averyanalex/nto-aerospace-2023/hardware/source/CameraHolder.png

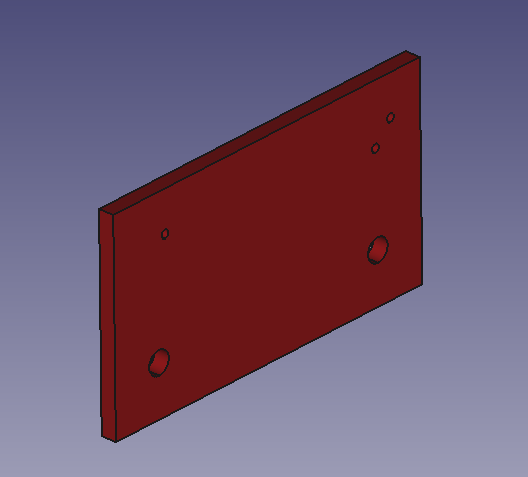
hardware/source/CameraHolder.png
