averyanalex/nto-aerospace-2023/hardware/source/Claw.png

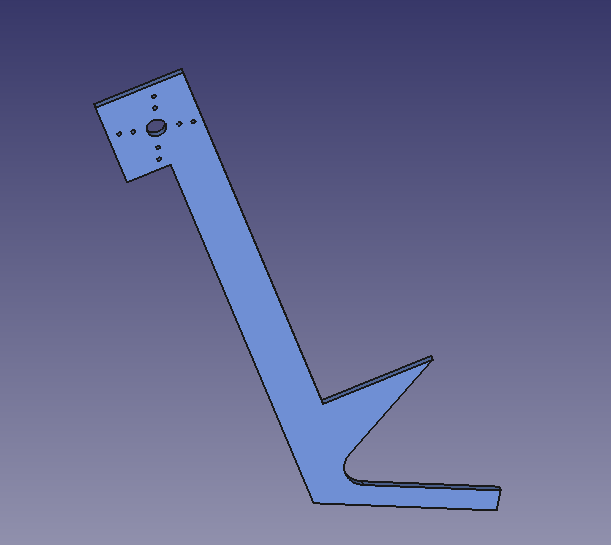
hardware/source/Claw.png
