averyanalex/nto-aerospace-2023/hardware/source/ClawDELETE.png

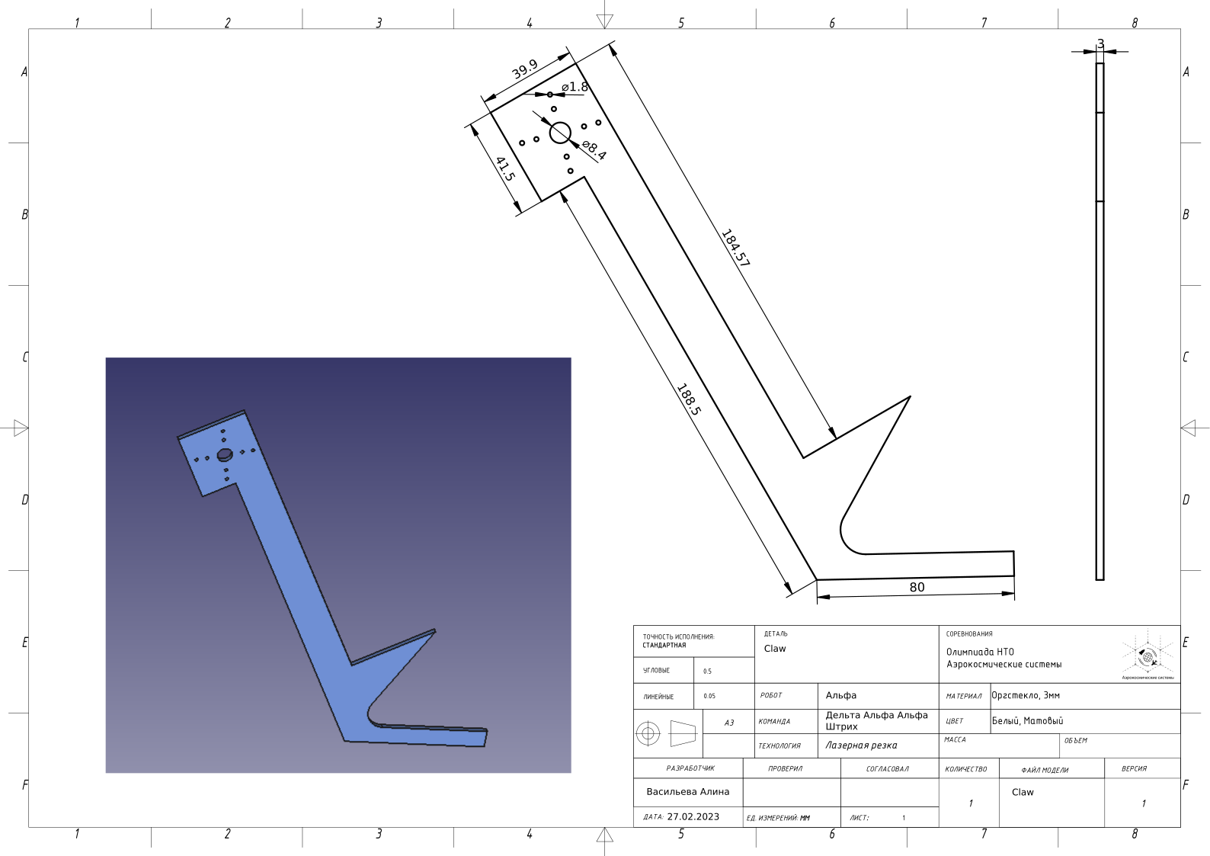
hardware/source/ClawDELETE.png
