averyanalex/nto-aerospace-2023/hardware/source/ServoHolder.png

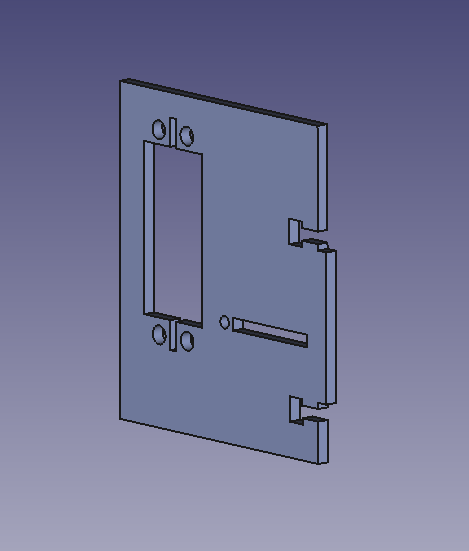
hardware/source/ServoHolder.png
