averyanalex/nto-aerospace-2023/hardware/source/ServoHolderRetainer.png

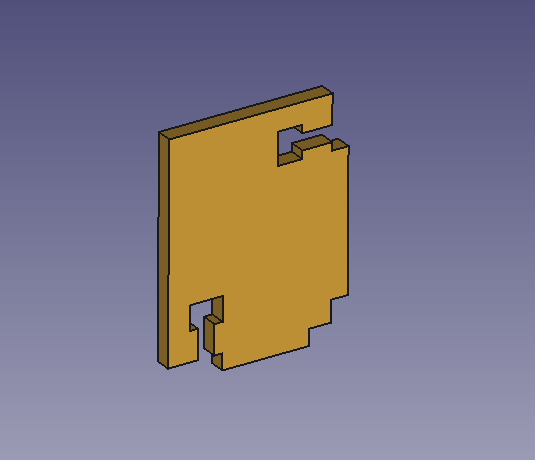
hardware/source/ServoHolderRetainer.png
