averyanalex/nto-aerospace-2023/hardware/source/TopPanel.png

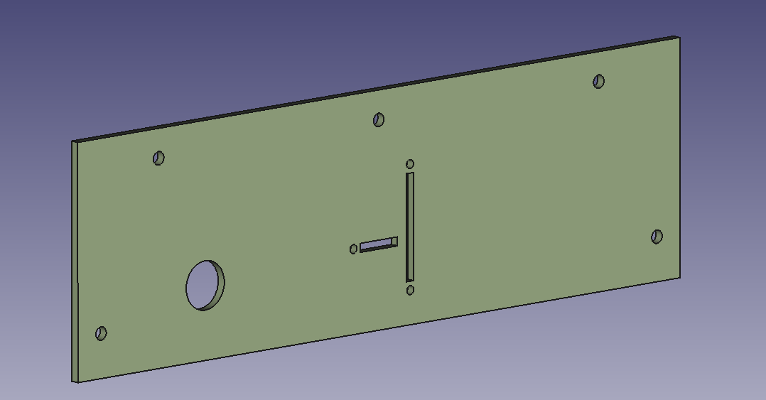
hardware/source/TopPanel.png
