averyanalex/nto-aerospace-2023/hardware/models/partslist.pdf

Команда "Дельта Альфа Альфа Штрих"
Список деталей для изготовления, Заказ №1
ПП | Модель | 3D | Название | Количество

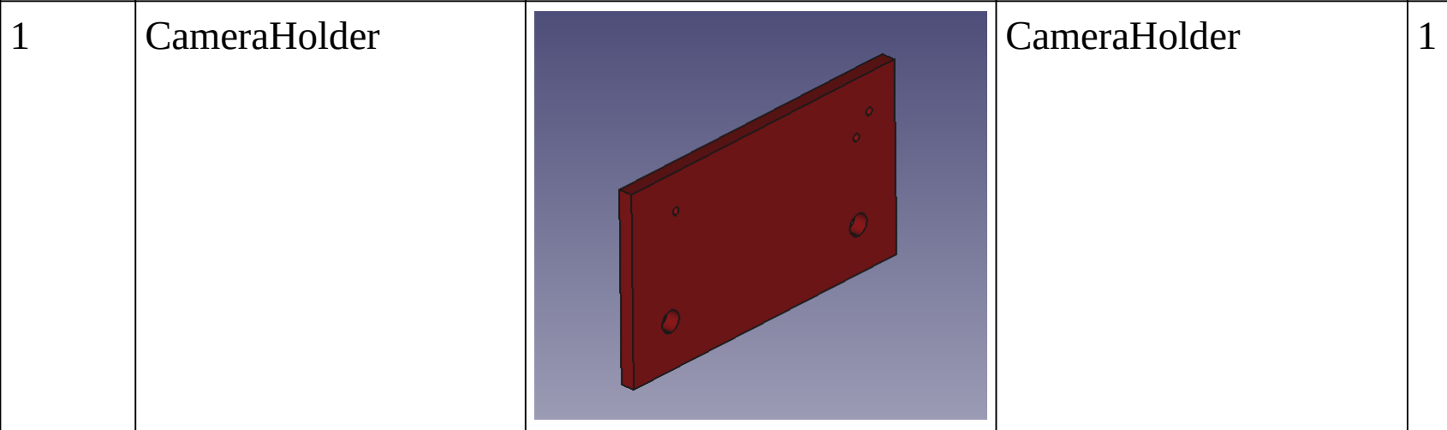
[picture p17: figure]
CameraHolder
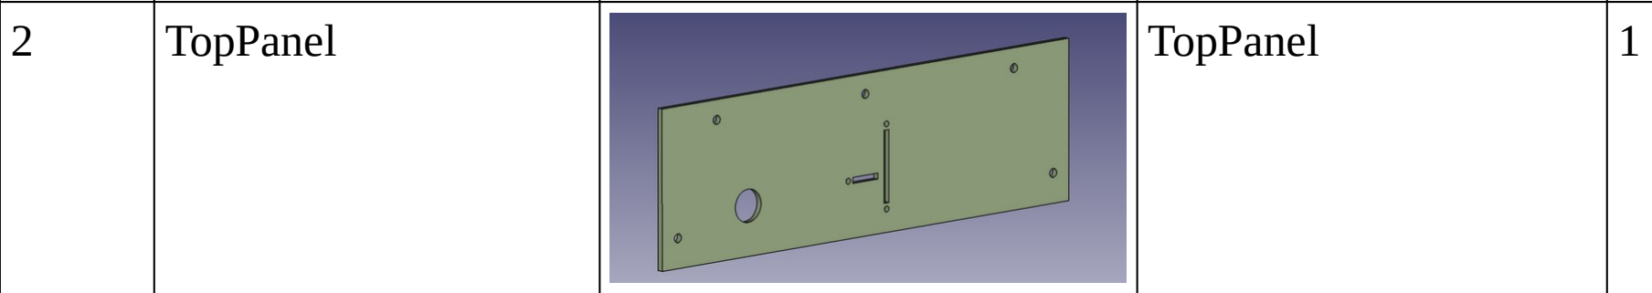
[picture p18: figure]
TopPanel
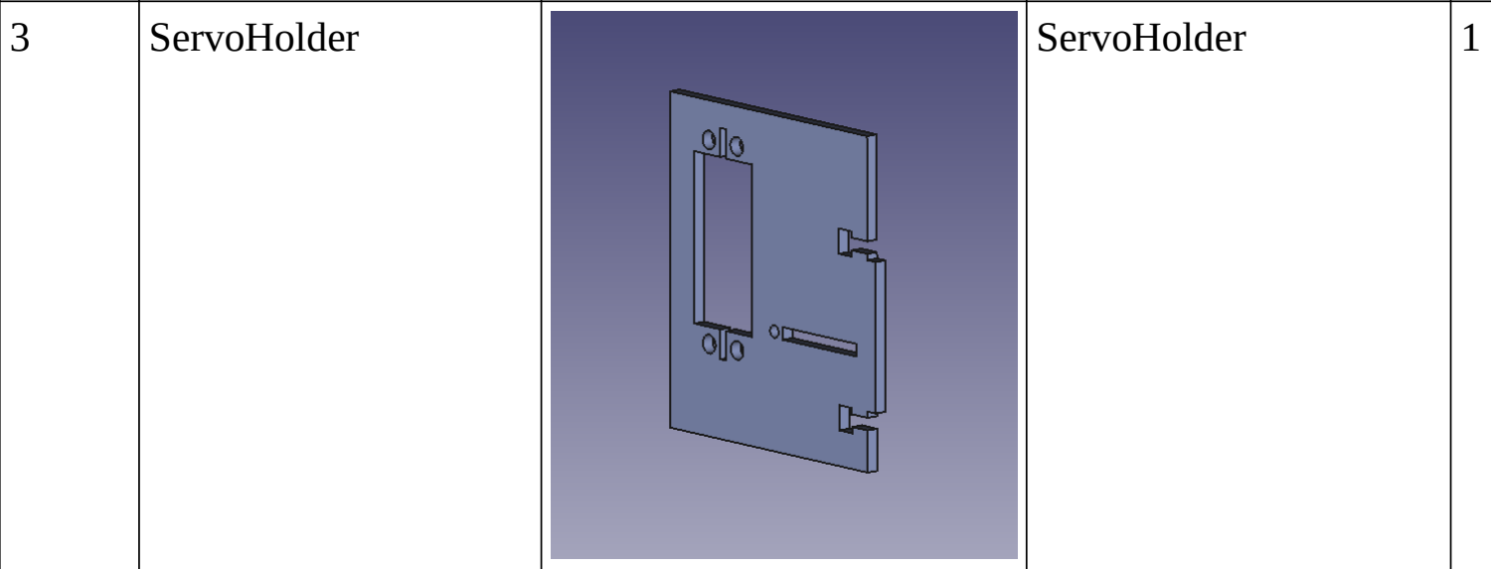
[picture p19: figure]
ServoHolder
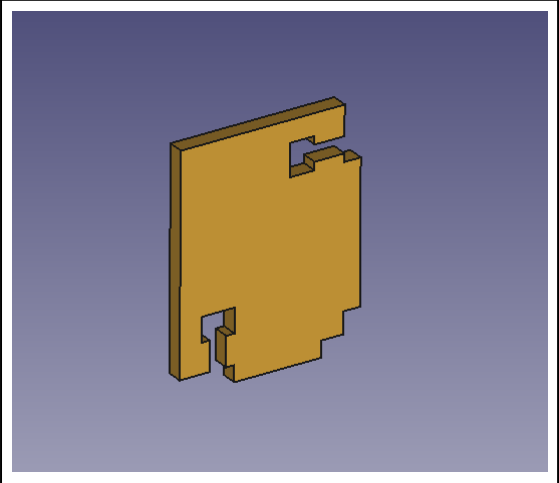
[picture p20: figure]

4 | ServoHolderRetainer | | ServoHolderRetainer | 1

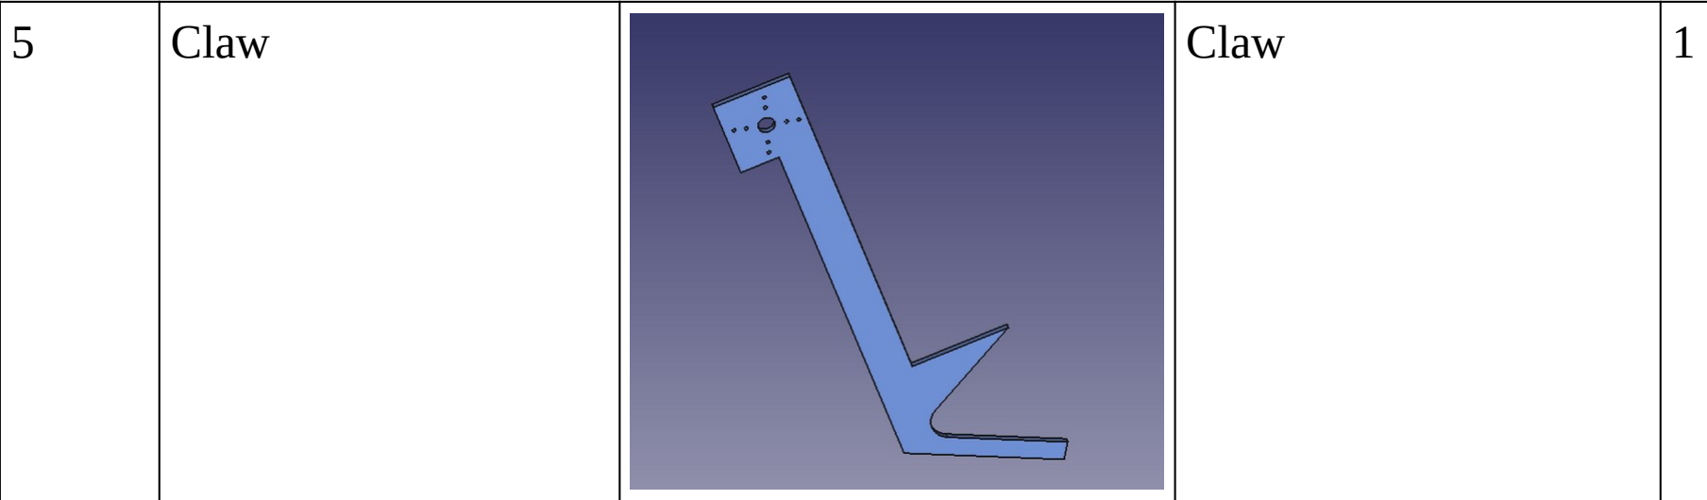
[picture p21: figure]
Claw
