averyanalex/nto-aerospace-2023/hardware/Alpha.FCStd

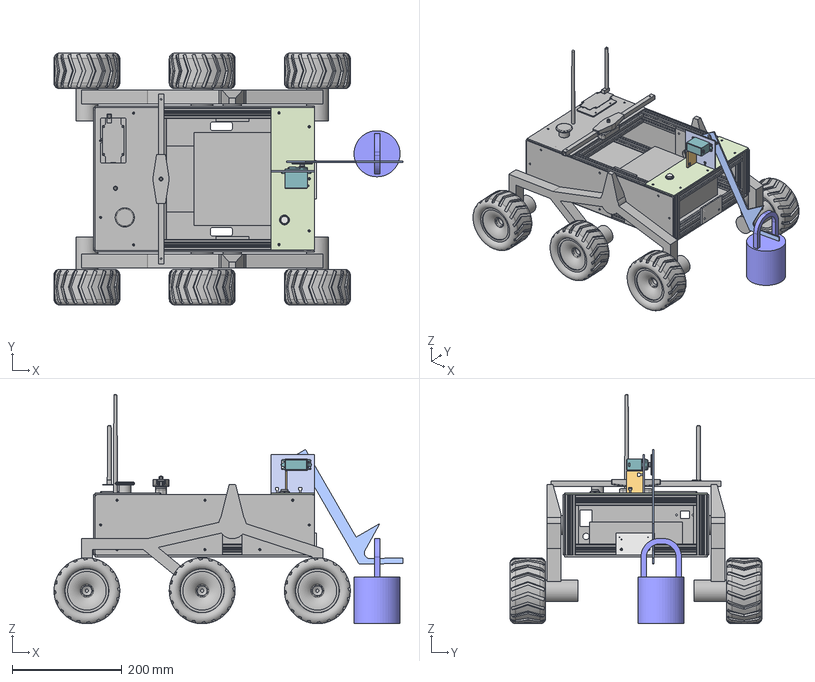
[picture p22: CAD file, 2023-02-27]
hardware/Alpha.FCStd
635.9 x 459.0 x 418.0 mm
CameraHolder
TopPanel
ServoHolder
ServoHolderRetainer
MG995-360
StdServo-X-arm
Rover-E3-base-dummie001
R16-503BD-G
Claw
