averyanalex/nto-aerospace-2023/hardware/models/TopPanel.dxf

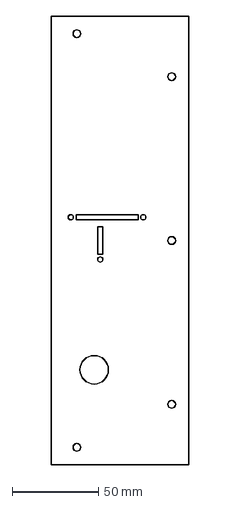
[picture p23: CAD file, 2023-02-27]
hardware/models/TopPanel.dxf
80.0 x 260.0 mm
