averyanalex/nto-aerospace-2023/hardware/models/ServoHolder.dxf

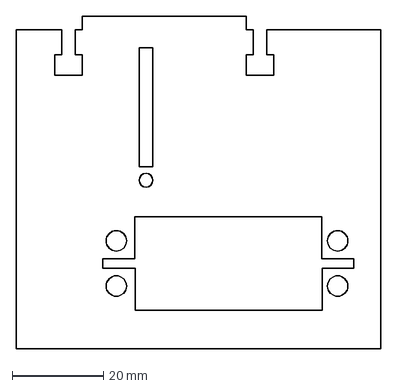
[picture p24: CAD file, 2023-02-27]
hardware/models/ServoHolder.dxf
80.0 x 73.0 mm
