averyanalex/nto-aerospace-2023/hardware/models/Claw.dxf

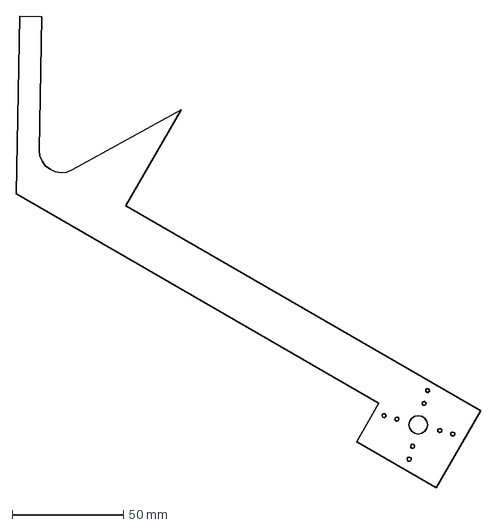
[picture p25: CAD file, 2023-02-27]
hardware/models/Claw.dxf
209.2 x 212.2 mm
