averyanalex/nto-aerospace-2023/hardware/models/CameraHolder.dxf

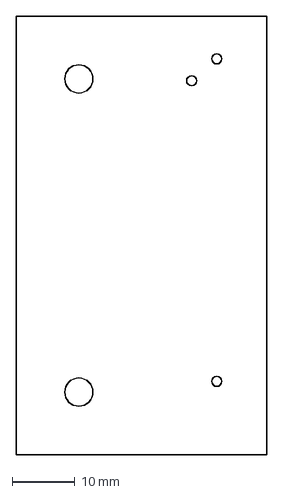
[picture p26: CAD file, 2023-02-27]
hardware/models/CameraHolder.dxf
40.0 x 70.0 mm
