averyanalex/nto-aerospace-2023/hardware/models/ServoHolderRetainer.dxf

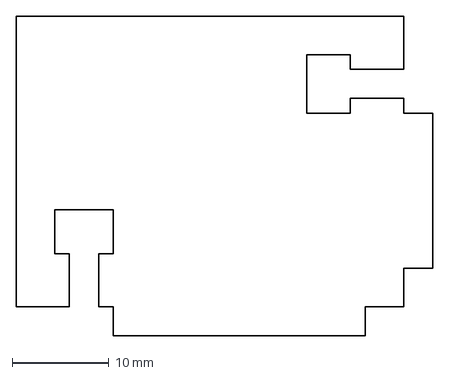
[picture p27: CAD file, 2023-02-27]
hardware/models/ServoHolderRetainer.dxf
43.0 x 33.0 mm
