averyanalex/nto-aerospace-2023/hardware/models/CameraHolder.pdf

70

⌀1.6

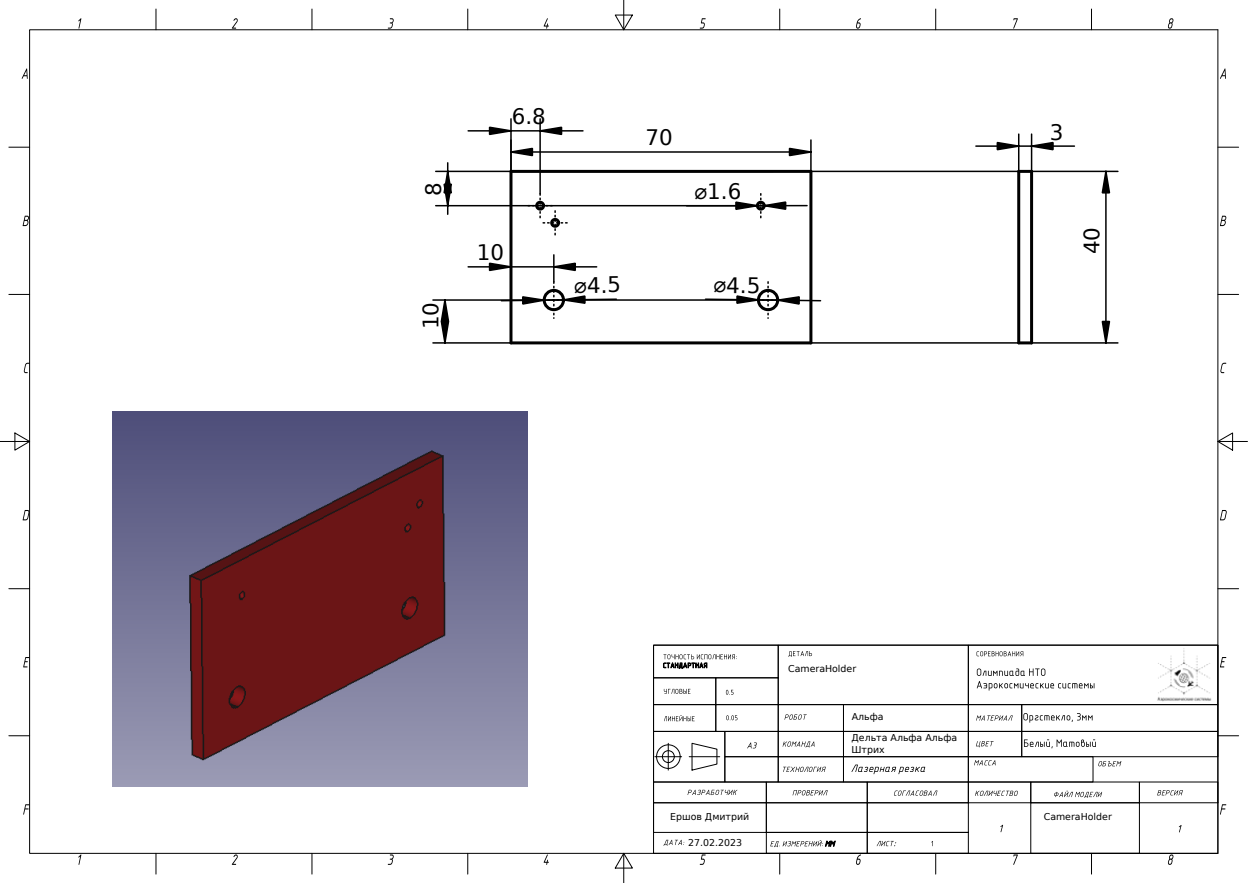
[picture p28: page 1]
Ершов Дмитрий; CameraHolder

Альфа
Дельта Альфа Альфа
Штрих
