averyanalex/nto-aerospace-2023/hardware/models/Claw.pdf

3

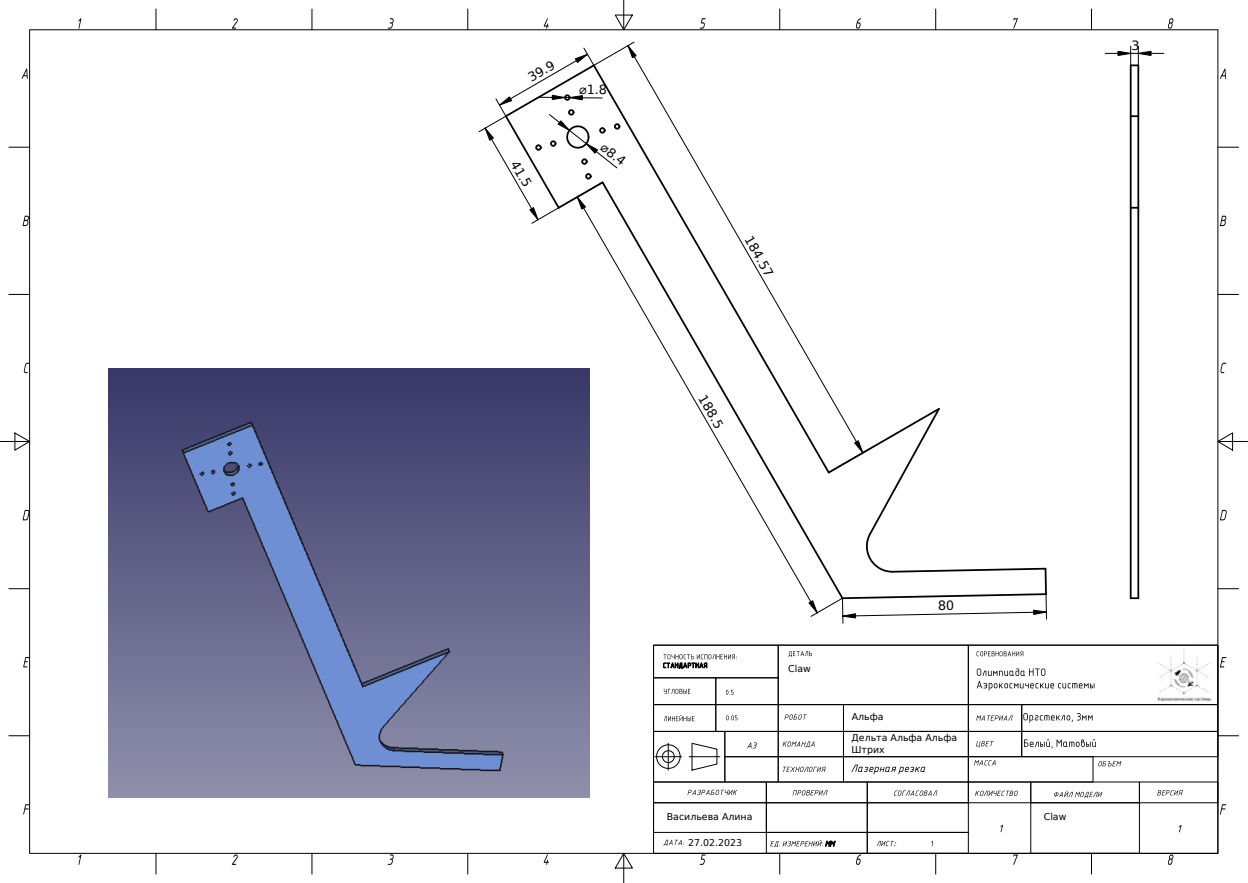
[picture p29: page 1]
Васильева Алина; Claw

Альфа
Дельта Альфа Альфа
Штрих
