averyanalex/nto-aerospace-2023/hardware/models/ServoHolder.pdf

80
41

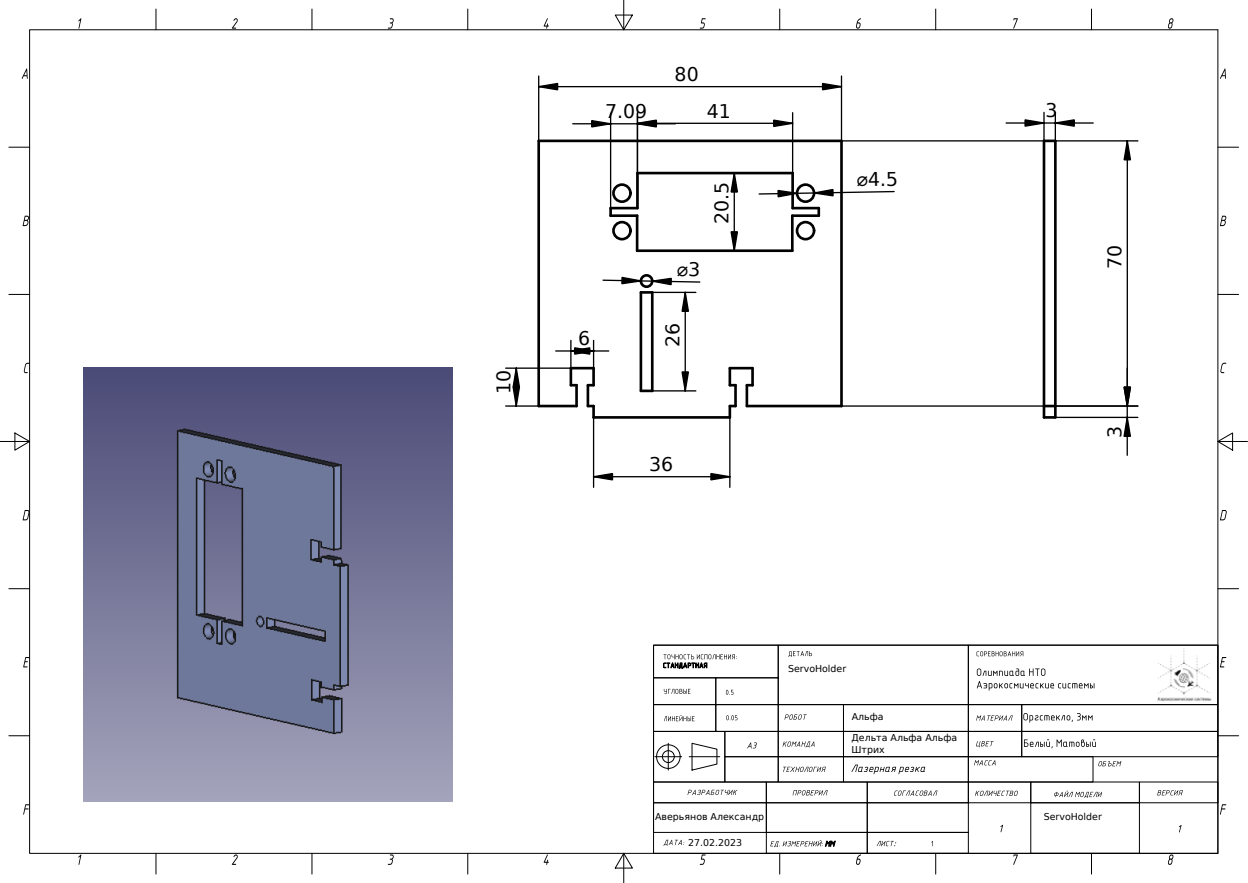
[picture p30: page 1]
Аверьянов Александр; ServoHolder

Альфа
Дельта Альфа Альфа
Штрих
