averyanalex/nto-aerospace-2023/hardware/models/ServoHolderRetainer.pdf

16 6

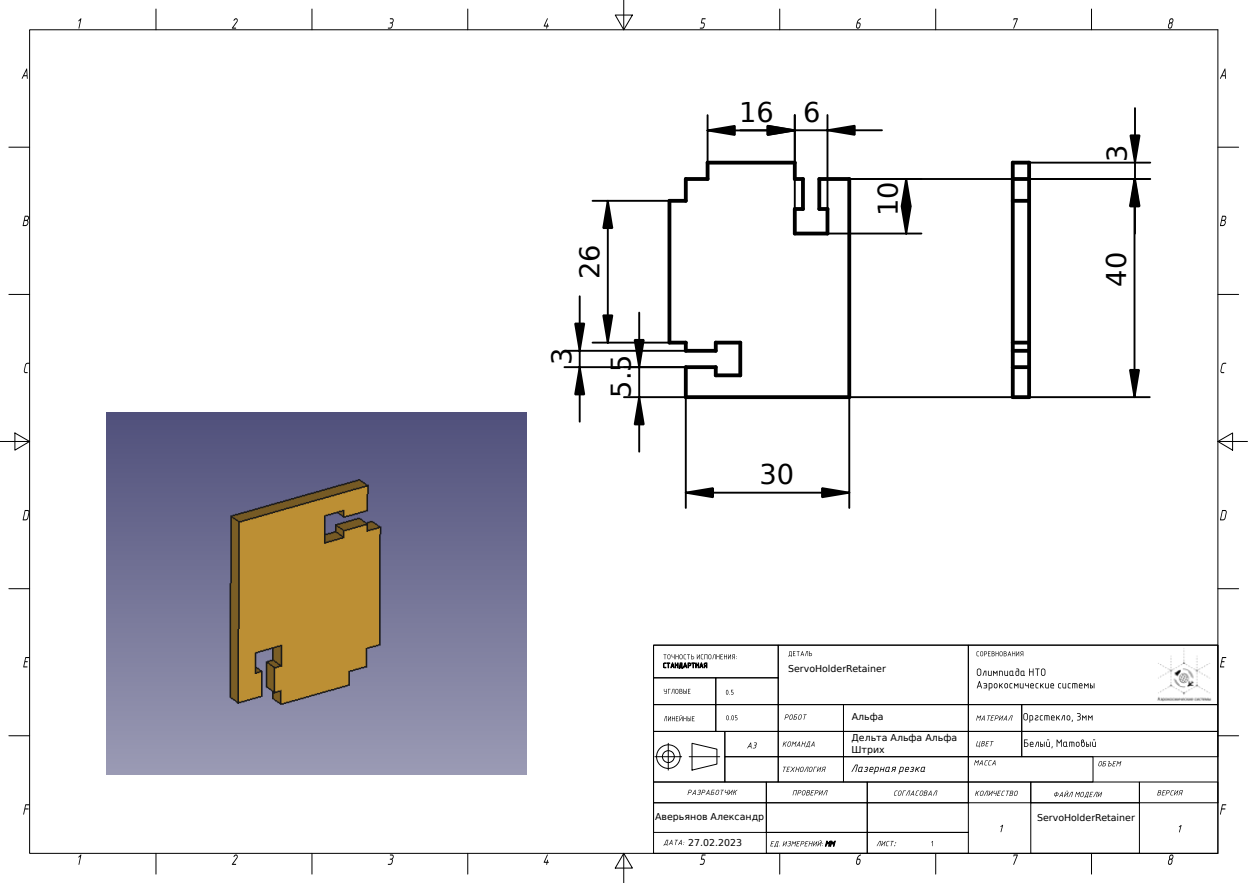
[picture p31: page 1]
Аверьянов Александр; ServoHolderRetainer; ServoHolderRetainer40

Альфа
Дельта Альфа Альфа
Штрих
