averyanalex/nto-aerospace-2023/hardware/electro.pdf

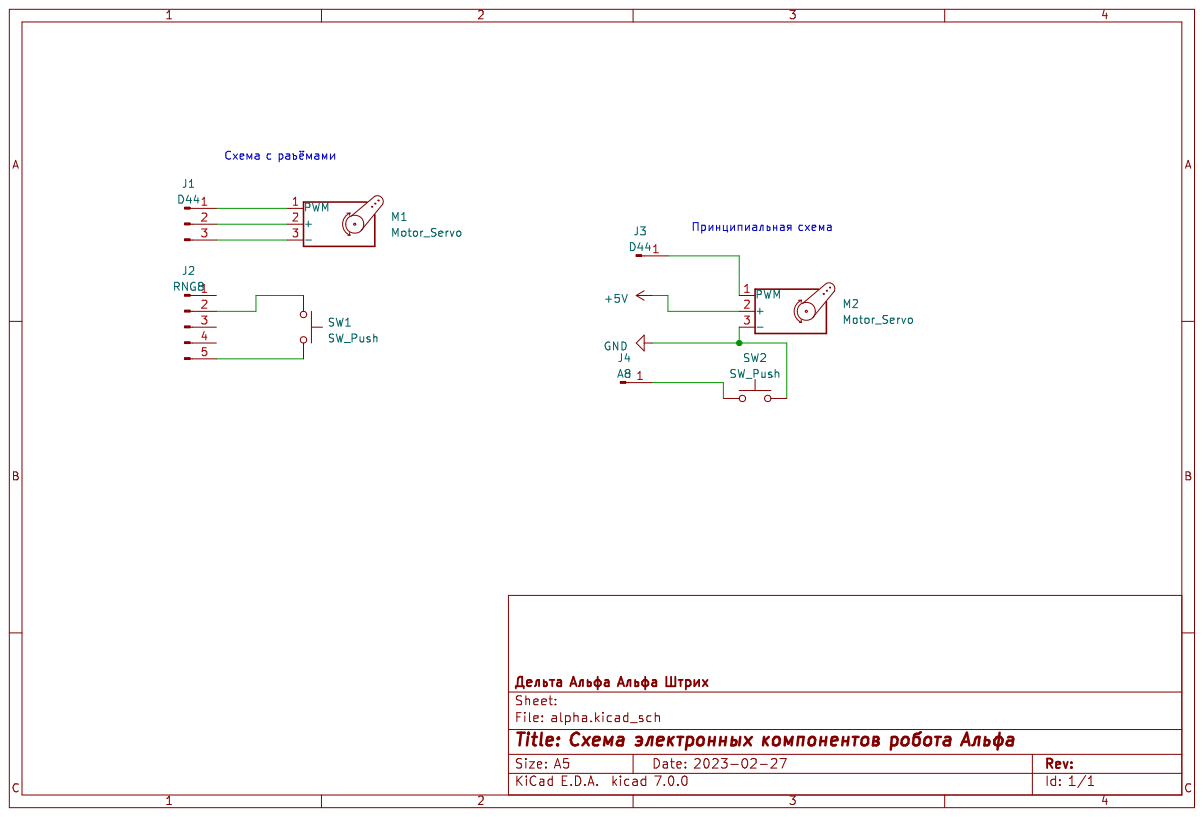
[picture p32: page 1]
