averyanalex/nto-aerospace-2023/hardware/models/TopPanel.pdf

260
3

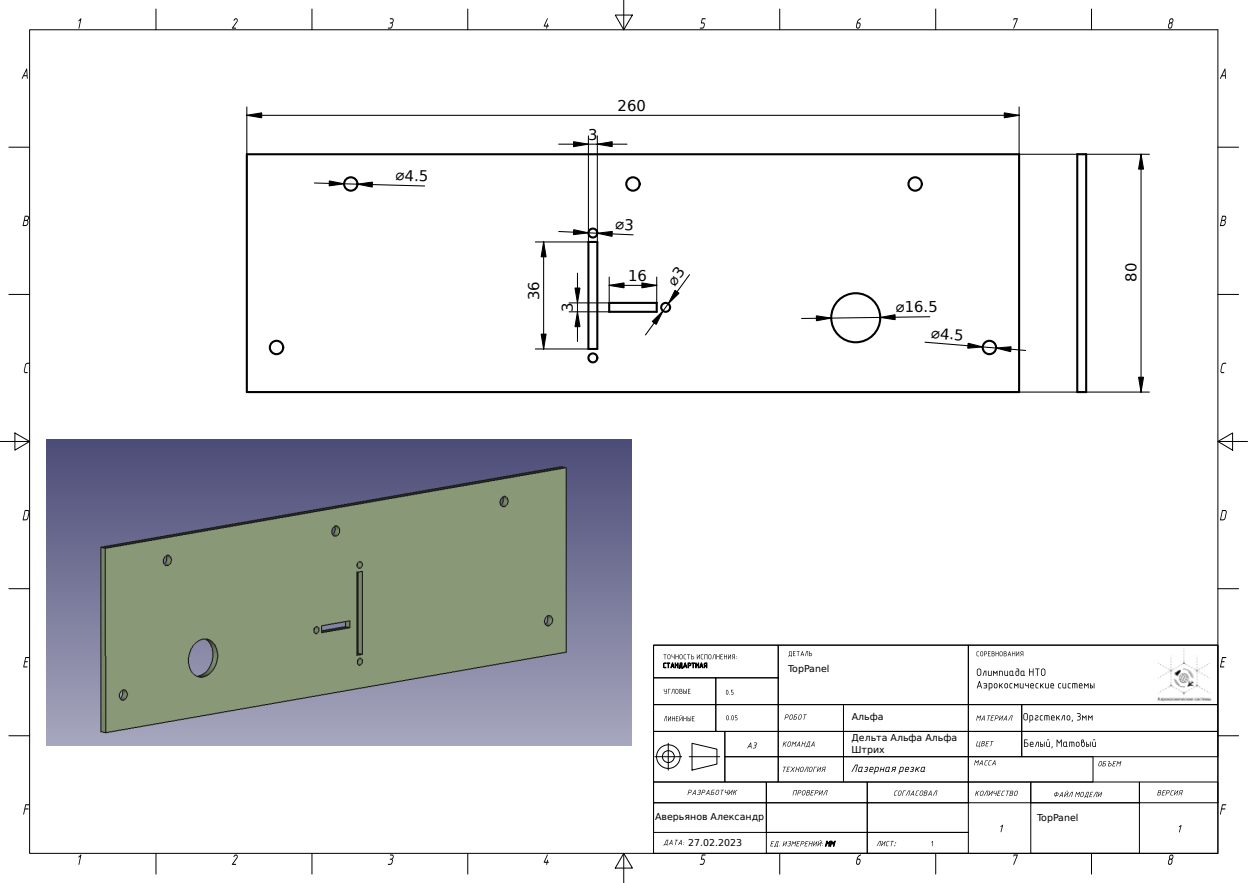
[picture p33: page 1]
Аверьянов Александр; TopPanel

Альфа
Дельта Альфа Альфа
Штрих
