averyanalex/nto-aerospace-2023/(commit log)

2023-02-27 Model visual updates
    [Alpha.FCStd]
2023-02-27 Fix claw
    [Alpha.FCStd]
2023-02-27 Threaded camera M2 holes
    [Alpha.FCStd]
2023-02-27 Assembly instructions
2023-02-27 Arduino flash instructions
2023-02-27 Add dxf models
    [CameraHolder.dxf, Claw.dxf, ServoHolder.dxf, ServoHolderRetainer.dxf, TopPanel.dxf]
2023-02-27 Update claw
2023-02-27 A8 buttons
2023-02-27 Add schematics
    [Alpha.FCStd]
2023-02-27 Add kicad drawing
2023-03-02 Reorganize repo
    [Alpha.FCStd, CameraHolder.dxf, Claw.dxf, ServoHolder.dxf, ServoHolderRetainer.dxf, TopPanel.dxf]
2023-03-02 Add arduino scripts
2023-03-03 Camera reader (#19)
    Closes #6
2023-03-04 Camera AV1 encoder (#20)
    * AV1 encoder
    * Fix encoder
    * Update
    * YUV -> RGB converter
    * Update cargo settings
    * Cleanup flake
    * Send decoded images
    [main.rs]
2023-03-05 Servo controller
2023-03-06 Drop all except 1 frame
2023-03-06 Const speed servo
2023-03-06 Servo control
    Closes #10
2023-03-06 Push button to drive 1m
2023-03-07 Limit odometry
2023-03-07 Muskrat: write 0x07 on button push
2023-03-07 Muskrat button handler
2023-03-08 Fix radio serial path
    [radiows.rs, rchost.rs]
2023-03-09 Add servo control t arduino
2023-03-09 Add arm control
